adafruit/Adafruit-TPL5111-Reset-Enable-Timer-PCB/Adafruit TPL5111 Reset Enable Timer.brd

## EAGLE design Adafruit TPL5111 Reset Enable Timer.brd (2017-08-16)

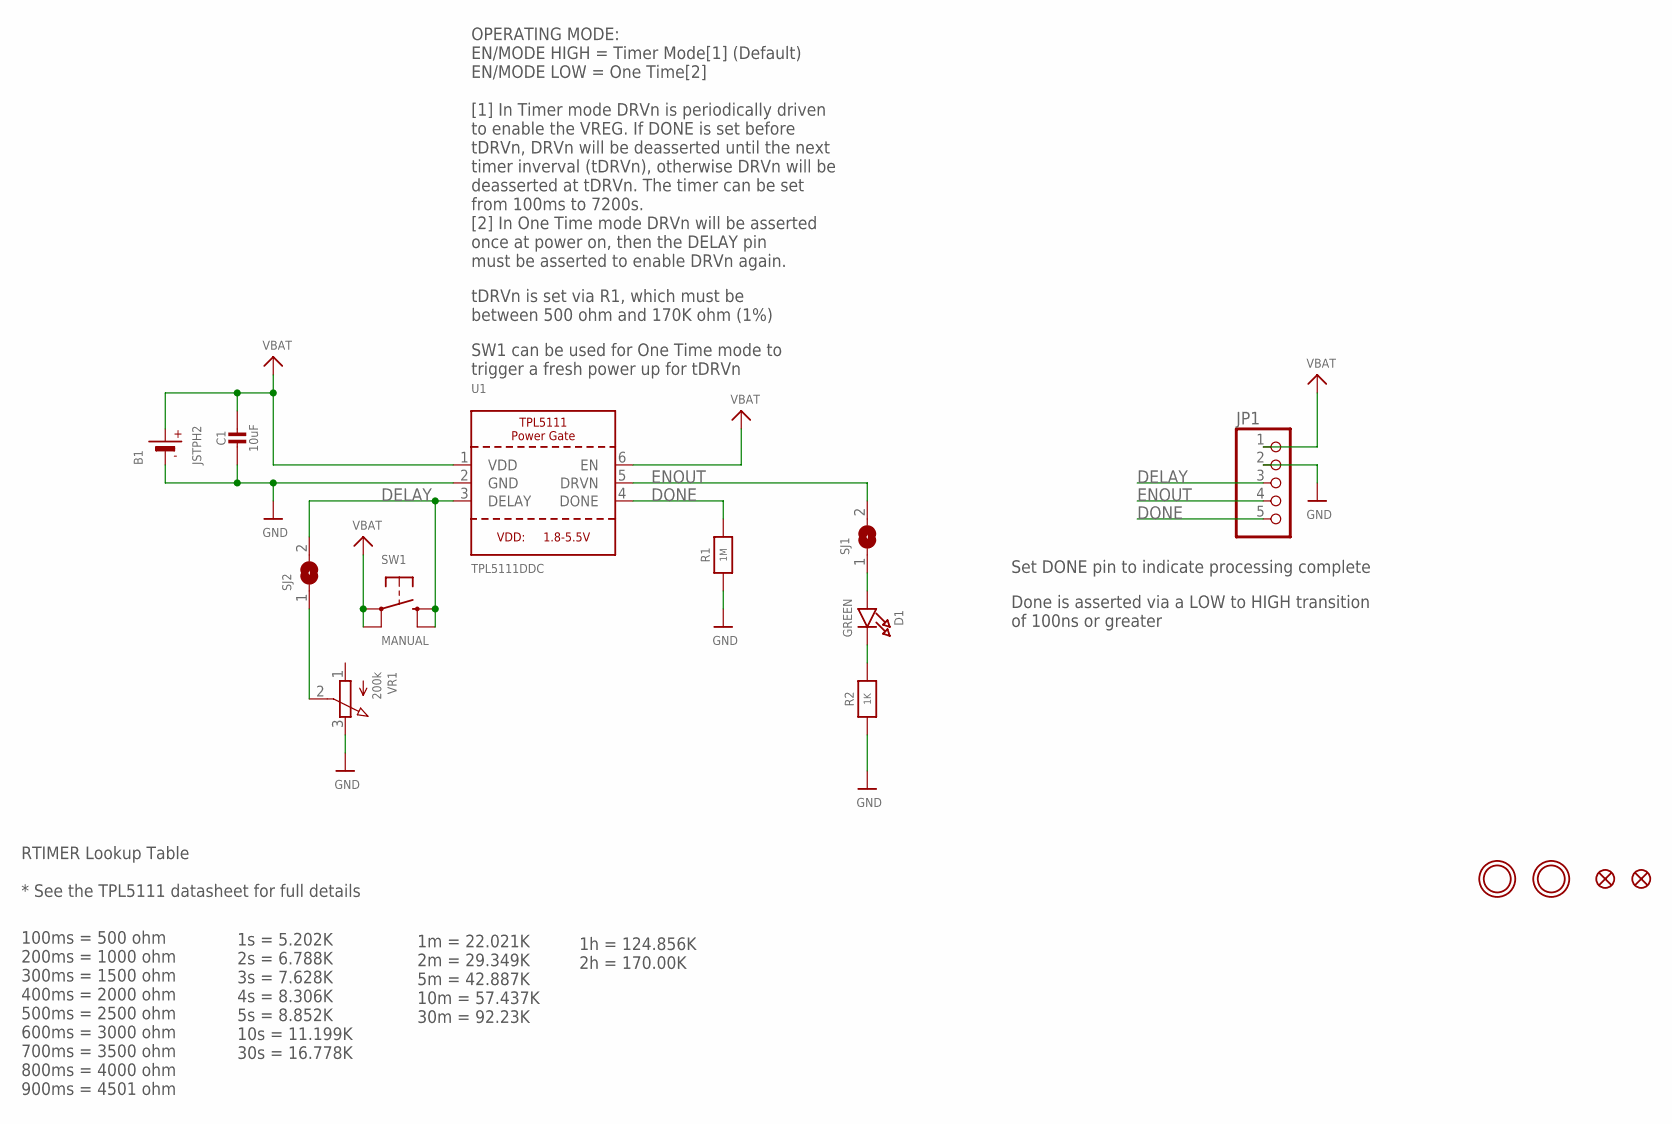
[picture p2: schematic Adafruit TPL5111 Reset Enable Timer.sch]

Parts:
B1: JSTPH2
C1: 10uF; 0805-NO
D1: GREEN; CHIPLED_0805_NOOUTLINE
FID2, FID3: FIDUCIAL_1MM
JP1: HEADER-1X576MIL; 1X05_ROUND_76
R1: 1M; 0805-NO
R2: 1K; 0805-NO
SJ1, SJ2: SOLDERJUMPERCLOSED; SOLDERJUMPER_CLOSEDWIRE
SW1: MANUAL; EVQ-Q2_SMALLER
U1: TPL5111DDC; SOT23-6
U$8, U$9: MOUNTINGHOLE2.5; MOUNTINGHOLE_2.5_PLATED
VR1: 200k; TRIMPOT_BOURNS_TC33X-2

Connections:
DELAY: JP1.3, SJ2.2, SW1.B (S), SW1.B' (S1), U1.3 (DELAY)
DONE: JP1.5, R1.2, U1.4 (DONE)
ENOUT: JP1.4, SJ1.2, U1.5 (DRVN)
GND: B1.1 (-), C1.2, JP1.2, R1.1, R2.1, U1.2 (GND), VR1.3 (E)
unnamed: SJ2.1, VR1.2 (S)
unnamed: D1.A, SJ1.1
unnamed: D1.C, R2.2
VDD: B1.2 (+), C1.1, JP1.1, SW1.A, SW1.A' (P1), U1.1 (VDD), U1.6 (EN)

Notes on the sheet:
OPERATING MODE: EN/MODE HIGH = Timer Mode[1] (Default) EN/MODE LOW = One Time[2] [1] In Timer mode DRVn is periodically driven to enable the VREG. If DONE is set before tDRVn, DRVn will be deasserted until the next timer inverval (tDRVn), otherwise DRVn will be deasserted at tDRVn. The timer can be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
Set DONE pin to indicate processing complete
Done is asserted via a LOW to HIGH transition of 100ns or greater
tDRVn is set via R1, which must be between 500 ohm and 170K ohm (1%)
SW1 can be used for One Time mode to trigger a fresh power up for tDRVn
RTIMER Lookup Table * See the TPL5111 datasheet for full details
100ms = 500 ohm 200ms = 1000 ohm 300ms = 1500 ohm 400ms = 2000 ohm 500ms = 2500 ohm 600ms = 3000 ohm 700ms = 3500 ohm 800ms = 4000 ohm 900ms = 4501 ohm
1s = 5.202K 2s = 6.788K 3s = 7.628K 4s = 8.306K 5s = 8.852K 10s = 11.199K 30s = 16.778K
1m = 22.021K 2m = 29.349K 5m = 42.887K 10m = 57.437K 30m = 92.23K
1h = 124.856K 2h = 170.00K

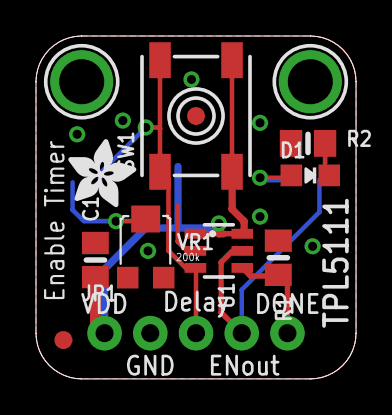
[picture p3: board Adafruit TPL5111 Reset Enable Timer.brd from above]

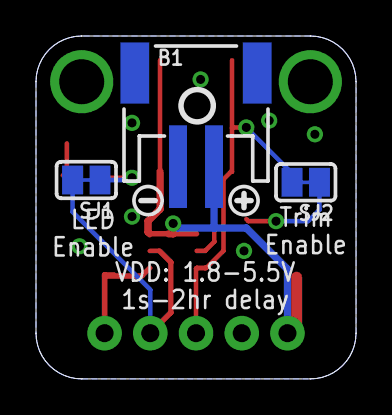
[picture p4: board Adafruit TPL5111 Reset Enable Timer.brd from below]

Board: 2 copper layers, 17.8 x 19.1 mm, 19 parts (6 on the bottom side), 8 nets.

Other parts of the board:
U$10: ADAFRUIT_3.5MM
U$11: SYMBOL_PLUS
U$12: SYMBOL_MINUS
U$15: PCBFEAT-REV-040
